FedeVerstraeten/actuador_electrodinamico/Anteproyecto/styles/cover.tex

%******************************************************
%* Santiago Roman (FIUBA #93947)
%******************************************************
% Estilo de la caratula
% -----------------------------------------------------

\thispagestyle{empty}
\newgeometry{twoside, left=2.5cm,top=1cm,right=2.5cm,bottom=1cm,bindingoffset=.5cm}
\begin{titlepage}

\begin{minipage}{0.48\textwidth} \begin{flushleft}
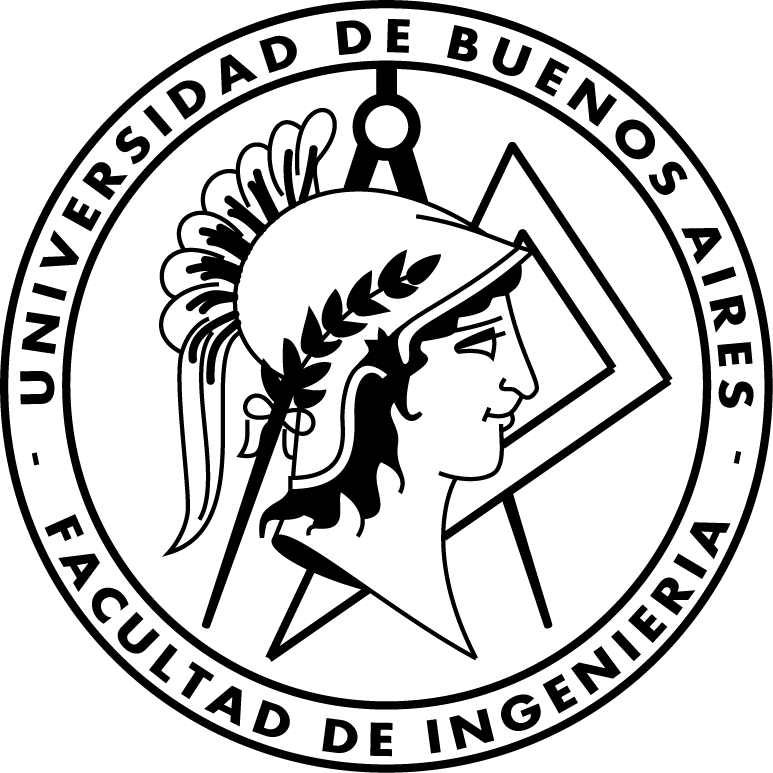
[picture p1: Anteproyecto/images/logo_fiuba.png]

\end{flushleft}\end{minipage}
\begin{minipage}{0.6\textwidth} \begin{flushright}
    \textsc{\Large \universidad}\\[0.5 cm]	% Nombre universidad
    \textsc{\Large \facultad}\\[2.0 cm]	% Facultad
\end{flushright}\end{minipage}

	\centering
%     \includegraphics[scale = 0.75]{images/logo_fiuba.png}\\[1.0 cm]	% Logo universidad
%     \textsc{\LARGE \universidad}\\[0.5 cm]	% Nombre universidad
%     \textsc{\Large \facultad}\\[2.0 cm]	% Facultad
%     \textsc{\Large \cuatrimestre}\\[2.0 cm]	% Cuatrimestre
% 	\textsc{\Large \codigoMateria}\\[0.5 cm] % Código materia
% 	\textsc{\large \nombreMateria}\\[0.5 cm] % Nombre materia
    \textsc{\large }\\[0.5 cm]
    \textsc{\large \nombreMateria  (\codigoMateria)}\\[0.5 cm] % Nombre materia
	\rule{\linewidth}{0.2 mm} \\[0.4 cm]
	{ \huge \tituloTP}\\[0.0cm]
	\rule{\linewidth}{0.2 mm} \\[1.5 cm]

\begin{table}[H]
\centering
\begin{tabular}{|l|l|l|}
\hline
Anteproyecto                  & \multicolumn{2}{l|}{Nombre del proyecto} \\ \hline
\multirow{3}{*}{Autores} &    Santiago Román       &     93947      \\ \cline{2-3} 
                  &     Santiago Román      &     93947      \\ \cline{2-3} 
                  &     Santiago Román      &     93947      \\ \hline
Turno de TP:                  & \multicolumn{2}{l|}{1 (Martes 19 a 22 hs)} \\ \hline
Docente Guía:                  &     \multicolumn{2}{l|}{Apellido, Nombre}                 \\ \hline
\end{tabular}
\end{table}

\begin{table}[H]
\centering
\begin{tabularx}{\textwidth}{|l|l|l|}
\hline
Anteproyecto                  & \multicolumn{2}{l|}{Nombre del proyecto} \\ \hline
\multirow{3}{*}{Autores} &    Santiago Román       &     93947      \\ \cline{2-3} 
                  &     Santiago Román      &     93947      \\ \cline{2-3} 
                  &     Santiago Román      &     93947      \\ \hline
Turno de TP:                  & \multicolumn{2}{l|}{1 (Martes 19 a 22 hs)} \\ \hline
Docente Guía:                  &     \multicolumn{2}{l|}{Apellido, Nombre}                 \\ \hline
\end{tabularx}
\end{table}

	\begin{minipage}{0.5\textwidth}
		\begin{flushleft} \large
			\emph{Integrante:}\\
		\end{flushleft}
	\end{minipage}~
	\begin{minipage}{0.4\textwidth}
		\begin{flushright} \large
			\emph{Padrón:} \\
		\end{flushright}
	\end{minipage}\\

    % Agregar aqui los integrantes del trabajo
    \teammember{Román, Santiago}{93947}{santiago\_roman@outlook.com}
    \teammember{Verstraeten, Federico}{XXXXX}{federico.verstraeten@gmail.com}
    \teammember{Zarza, Ezequiel Martín}{XXXXX}{ezequielm.zarza@gmail.com}

    \vfill
	
	{\large \today}\\[2 cm]
 
	\vfill

\end{titlepage}
\restoregeometry
