FedeVerstraeten/actuador_electrodinamico/Anteproyecto/0main.tex

\documentclass[a4paper]{styles/clase_fiuba}

\newcommand{\codigoMateria}{66.09 / 86.07}
\newcommand{\nombreMateria}{Laboratorio de Microprocesadores}

\newcommand{\descripcionTP}{Controlador de un actuador electrodinámico aplicado a interferometría dinámica}
\newcommand{\tituloTP}{Informe de Anteproyecto}

\newcommand{\facultad}{Facultad de Ingeniería}
\newcommand{\universidad}{Universidad de Buenos Aires}
\newcommand{\cuatrimestre}{1er Cuatrimestre de 2016}

\usepackage{styles/estilo_fiuba}

% ---------------------------------------------------------------
% Inicio documento
\begin{document}
\nocite{*}
% ---------------------------------------------------------------
% Caratula e índice
\includepdf[pages={1}]{caratula.pdf}
\clearpage

\pagenumbering{Roman}

\tableofcontents
\clearpage
% ---------------------------------------------------------------
% Cuerpo del informe.
\pagenumbering{arabic}
\pagestyle{fancy}

\input{1objet}

\input{2descrip}

\input{3especif}

\input{4perif}

\input{5diag_bloq}

\input{6diag_flujo}

\input{7plan_trabajo}

\input{8componentes}

\include{9fact_exito}

% --------------------------------------------------
% Bibliografías
%\bibliography{biblio}{}
%\bibliographystyle{plain}
%\clearpage
% --------------------------------------------------
% Fin del informee
\end{document}
