FedeVerstraeten/actuador_electrodinamico/Anteproyecto/5diag_bloq.tex

\section{Diagrama de bloques preliminar}
\label{sec:diag_bloq}
Quisque erat metus, cursus in pellentesque a, lobortis in diam. In hac habitasse platea dictumst. Nunc ac mauris ac felis luctus varius vel ac dui. Sed feugiat ullamcorper dolor, at aliquet ex ultricies id. Vivamus sed nulla sit amet magna consectetur elementum. Nulla sed lorem quis neque euismod feugiat et id leo. Aliquam placerat dapibus turpis. Cras sollicitudin vitae ante a feugiat. Fusce interdum quam a enim ultrices tristique. Vivamus sed volutpat turpis. Fusce feugiat velit id magna finibus convallis. Nulla malesuada leo id fermentum condimentum. Sed ultricies ornare metus varius varius.
