FedeVerstraeten/actuador_electrodinamico/Anteproyecto/9fact_exito.tex

\section{Factores críticos de éxito}
\label{sec:fact_exito}

Es importante analizar cuáles son los riesgos potenciales más importantes que podrían dificultar la realización del proyecto. Una vez identificados, conviene hacerles un seguimiento cercano para evitar contratiempos.

- Desarrollo de inferfaz entre
