FedeVerstraeten/actuador_electrodinamico/Informe/Caratula_Informe_Final.pdf

LABORATORIO DE MICROPROCESADORES (86.07) LABORATORIO DE MICROCOMPUTADORAS (66.09)

INFORME FINAL DE PROYECTO

Anteproyecto: | Controlador de un actuador electrodinámico aplicado a interferometría dinámica
Autores: | Roman, Santiago | 93947
| Verstraeten, Federico | 92892
| Zarza, Ezequiel M. | 93883
Turno de TP: | 1 (Martes 19 a 22hs)
Docente Guía: |

Observaciones generales

Aceptación del docente:

Fecha
