FedeVerstraeten/actuador_electrodinamico/ejemplos/lcd/conexiones vista lcd.gif

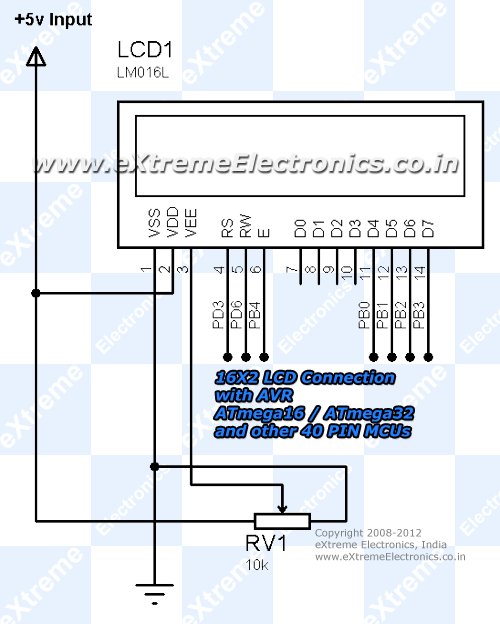
ejemplos/lcd/conexiones vista lcd.gif
