FedeVerstraeten/actuador_electrodinamico/ejemplos/poster/espectrofotocolrímetro.png

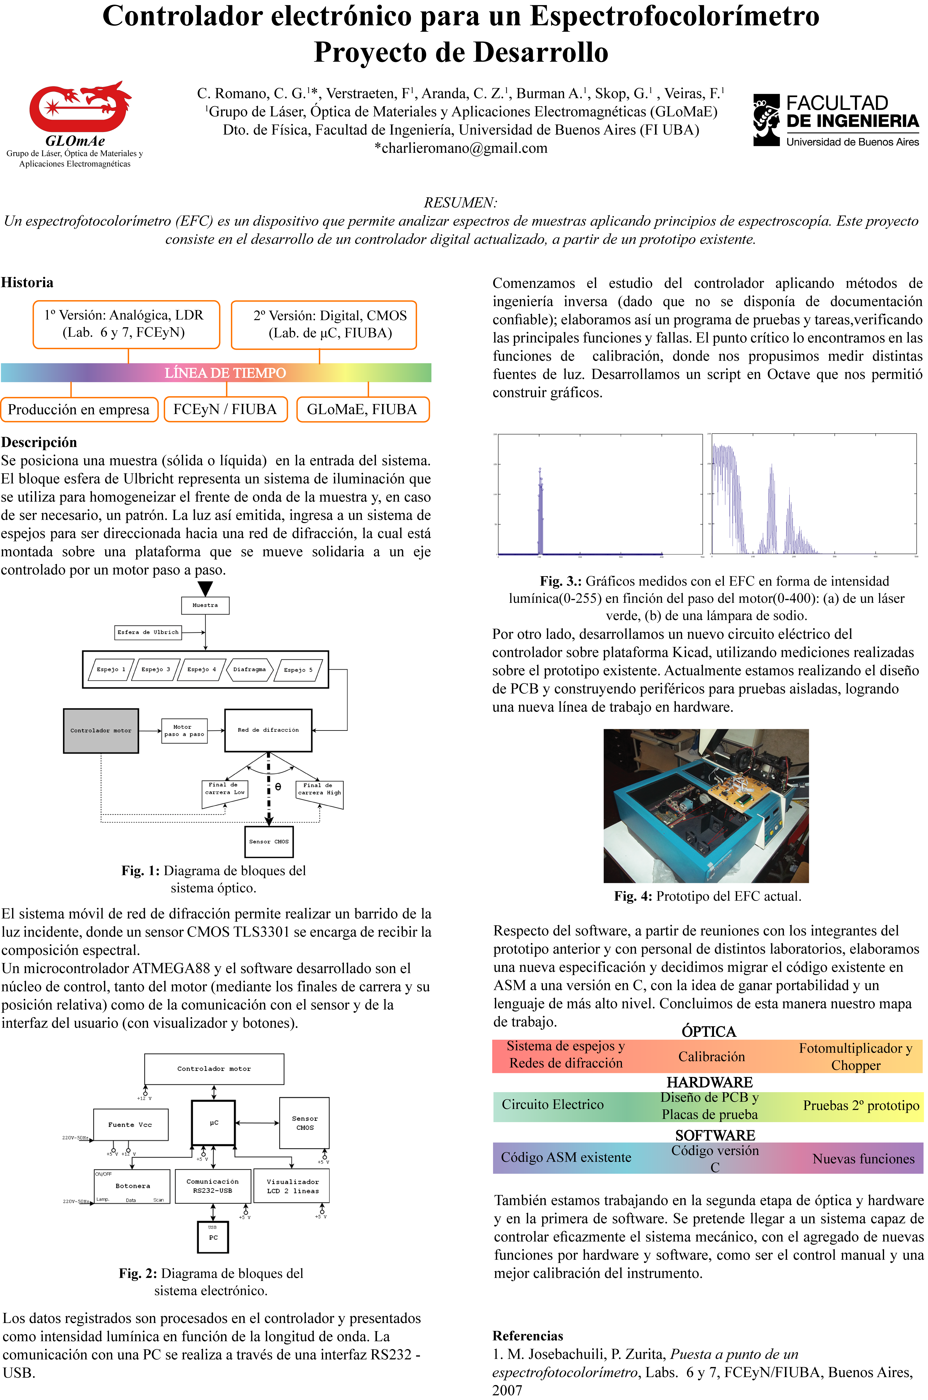
ejemplos/poster/espectrofotocolrímetro.png
