FedeVerstraeten/actuador_electrodinamico/Informe/images/atmega328p.jpg

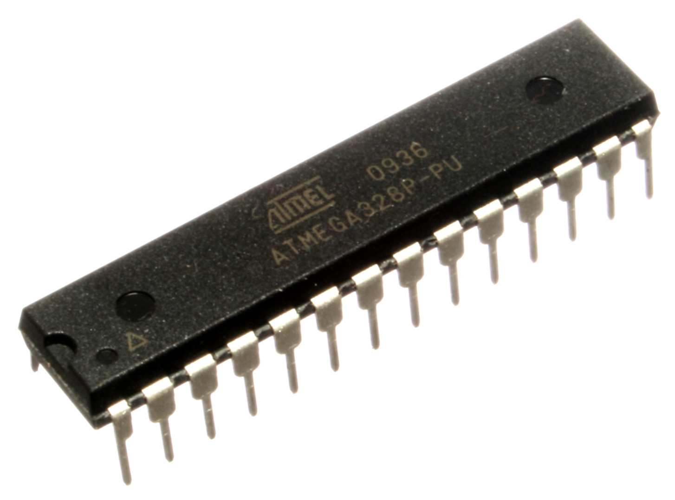
Informe/images/atmega328p.jpg
