FedeVerstraeten/actuador_electrodinamico/Informe/images/Diagrama_en_bloques.png

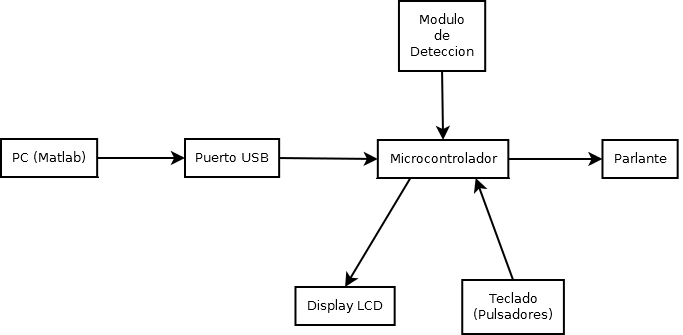
Informe/images/Diagrama_en_bloques.png
