FedeVerstraeten/actuador_electrodinamico/Informe/images/parlante_espejov2.png

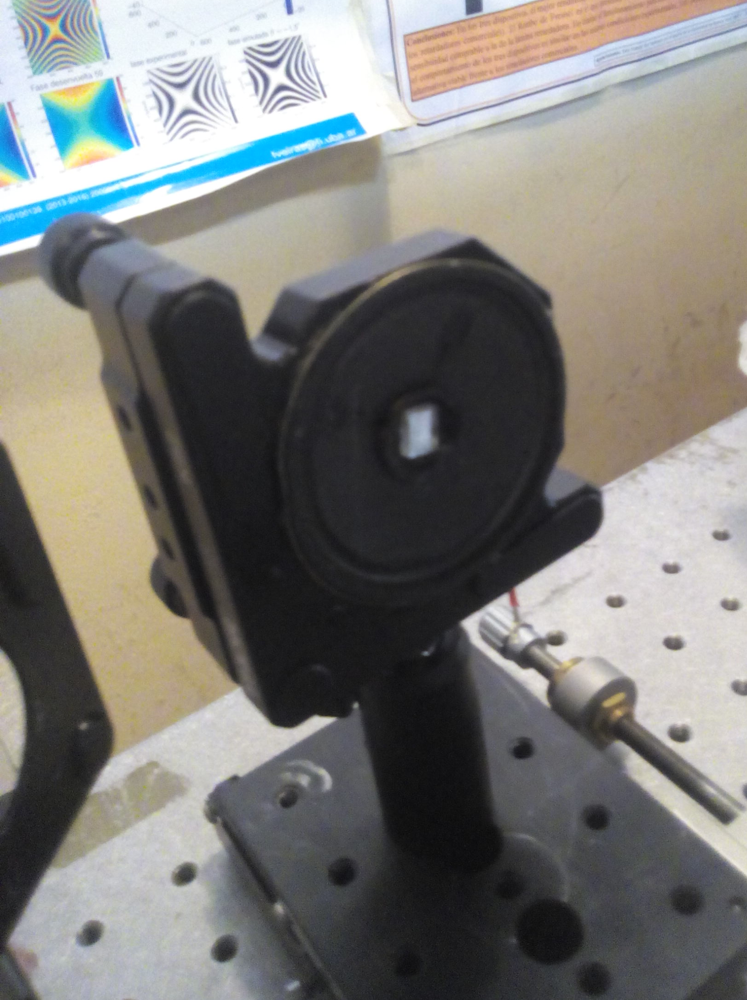
Informe/images/parlante_espejov2.png
