FedeVerstraeten/actuador_electrodinamico/Poster/img/interferometro1.jpg

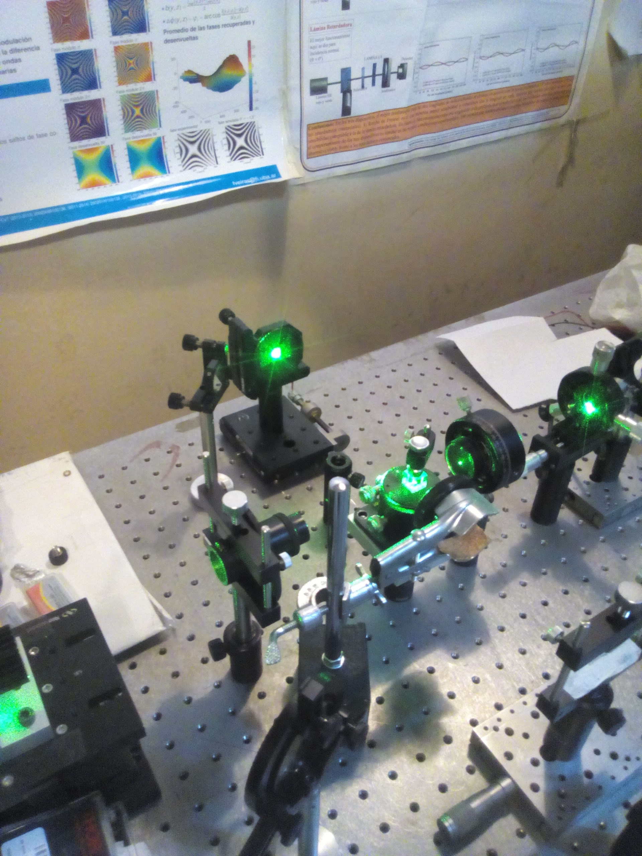
Poster/img/interferometro1.jpg
