FedeVerstraeten/actuador_electrodinamico/Poster/img/interferometro3.jpg

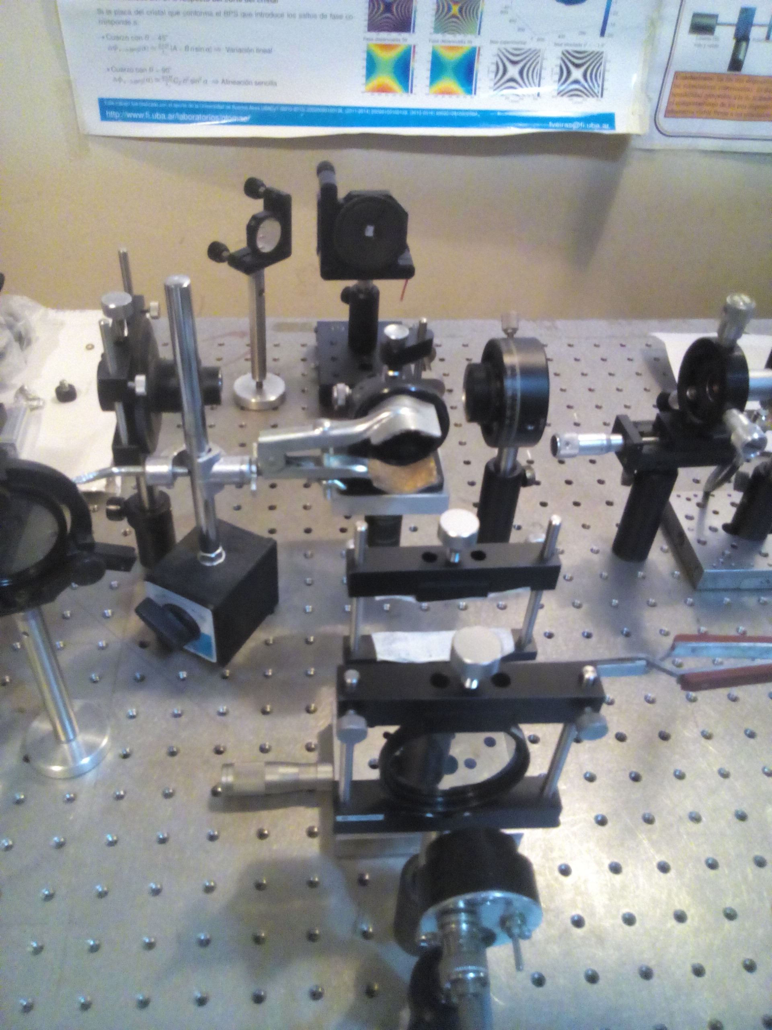
Poster/img/interferometro3.jpg
