FedeVerstraeten/actuador_electrodinamico/Poster/img/parlante_espejo.png

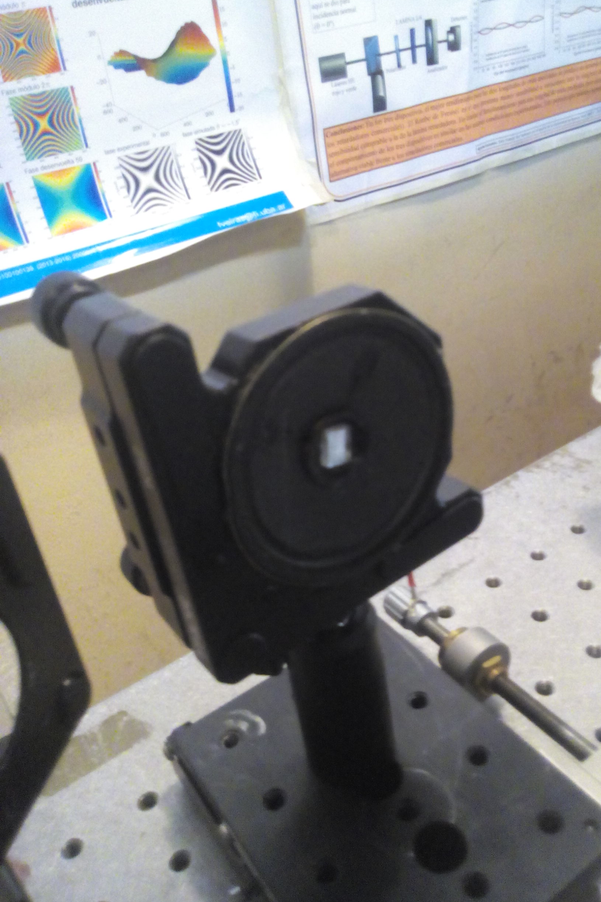
Poster/img/parlante_espejo.png
