FedeVerstraeten/actuador_electrodinamico/Informe/8componentes.tex

\section{Listado de componentes y costos estimados}
\label{sec:componentes}

\begin{table}[H]
  \centering
  \begin{tabular}{ll}
    \toprule
    Componente & Costo estimado \\
    \midrule
    Microcontrolador ATMega32 & \$ 225 \\
    Placa experimental & \$ 150 \\
    Soporte & \$ - \\
    Placa USB a Serie & \$ 120 \\
	Display LCD  & \$ 120 \\
	Parlante & \$ 50 \\
    4x Botones & \$ 20 \\
    Fotodiodo & \$ 5 \\
    16x Resistencias\footnote{Se incluyen a las resistencias ya que a pesar de ser un componente muy básico que en general no merece ser destacado en este caso estas resistencias conforman el conversor digital-analógico que se utilizó.} & \$ 10\\
    Cristal $\SI{16}{\mega \hertz}$ & \$ 6 \\
    \midrule
    Total & $\approx$ \$ 706 \\
    \bottomrule
  \end{tabular}
  \caption{Costos estimados para la realización del proyecto.}
  \label{table:costos}
\end{table}
