FedeVerstraeten/actuador_electrodinamico/Anteproyecto/8componentes.tex

\section{Listado de componentes y costos estimados}
\label{sec:componentes}

\begin{table}[H]
  \centering
  \begin{tabular}{ll}
    \toprule
    Componente & Costo estimado \\
    \midrule
    Microprocesador ATMega328p & \$ 110 \\
    Placa experimental & \$ ?? \\
    Soporte & \$ ?? \\
    Placa USB a Serie & $\approx$ \$ 120 \\
	Parlante & \$ ?? \\
    \midrule
    Total & \$ ?? \\
    \bottomrule
  \end{tabular}
  \caption{Costos estimados para la realización del proyecto.}
  \label{table:costos}
\end{table}
