FedeVerstraeten/actuador_electrodinamico/Informe/images/resultados_rampa_precargada.jpg

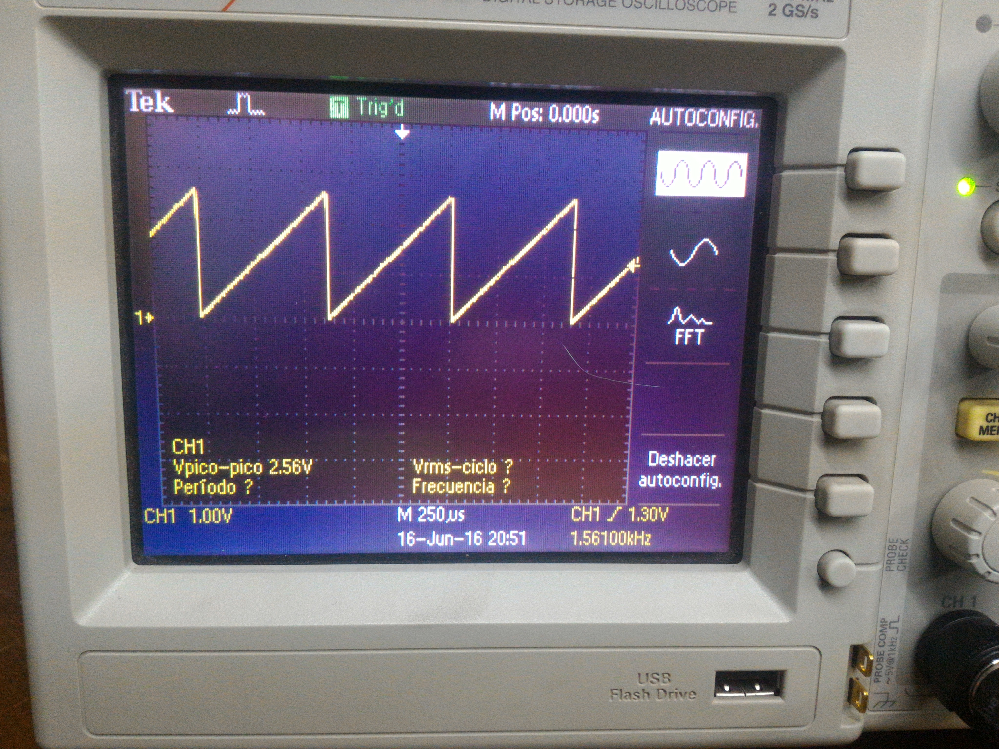
Informe/images/resultados_rampa_precargada.jpg
