FedeVerstraeten/actuador_electrodinamico/Informe/images/resultados_seno_precargada.jpg

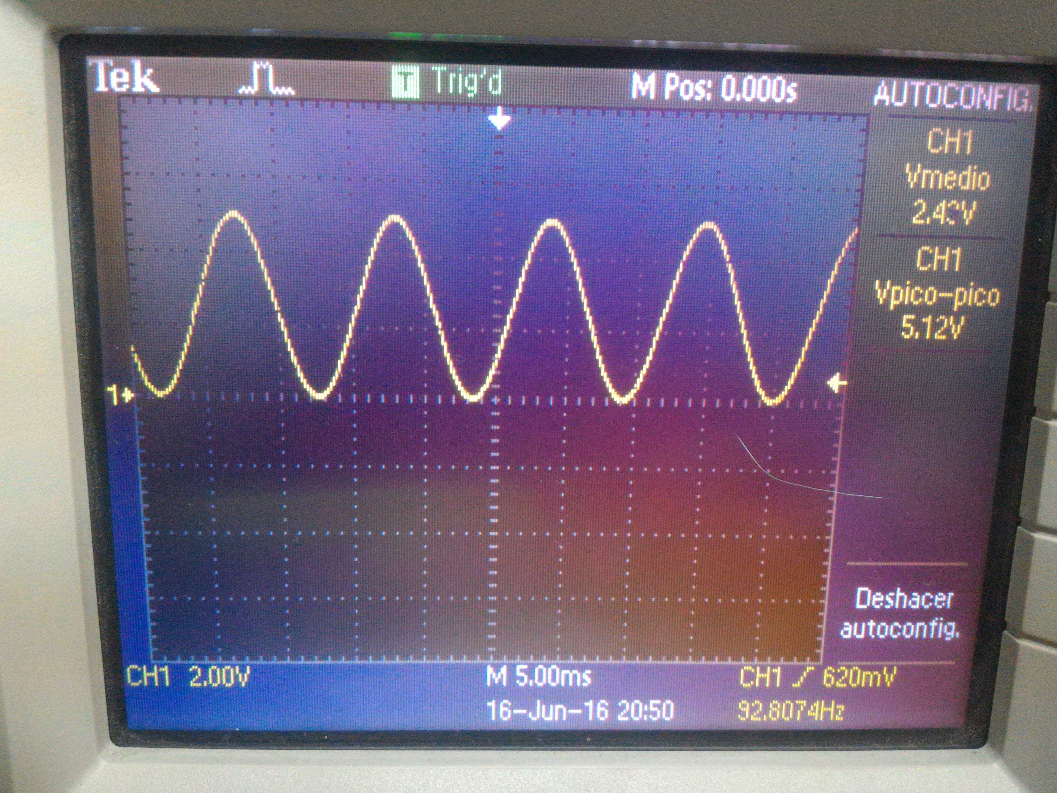
Informe/images/resultados_seno_precargada.jpg
