FedeVerstraeten/actuador_electrodinamico/Informe/images/ProyectoLaboratorioMicroprocesadores.PDF

J1

X1

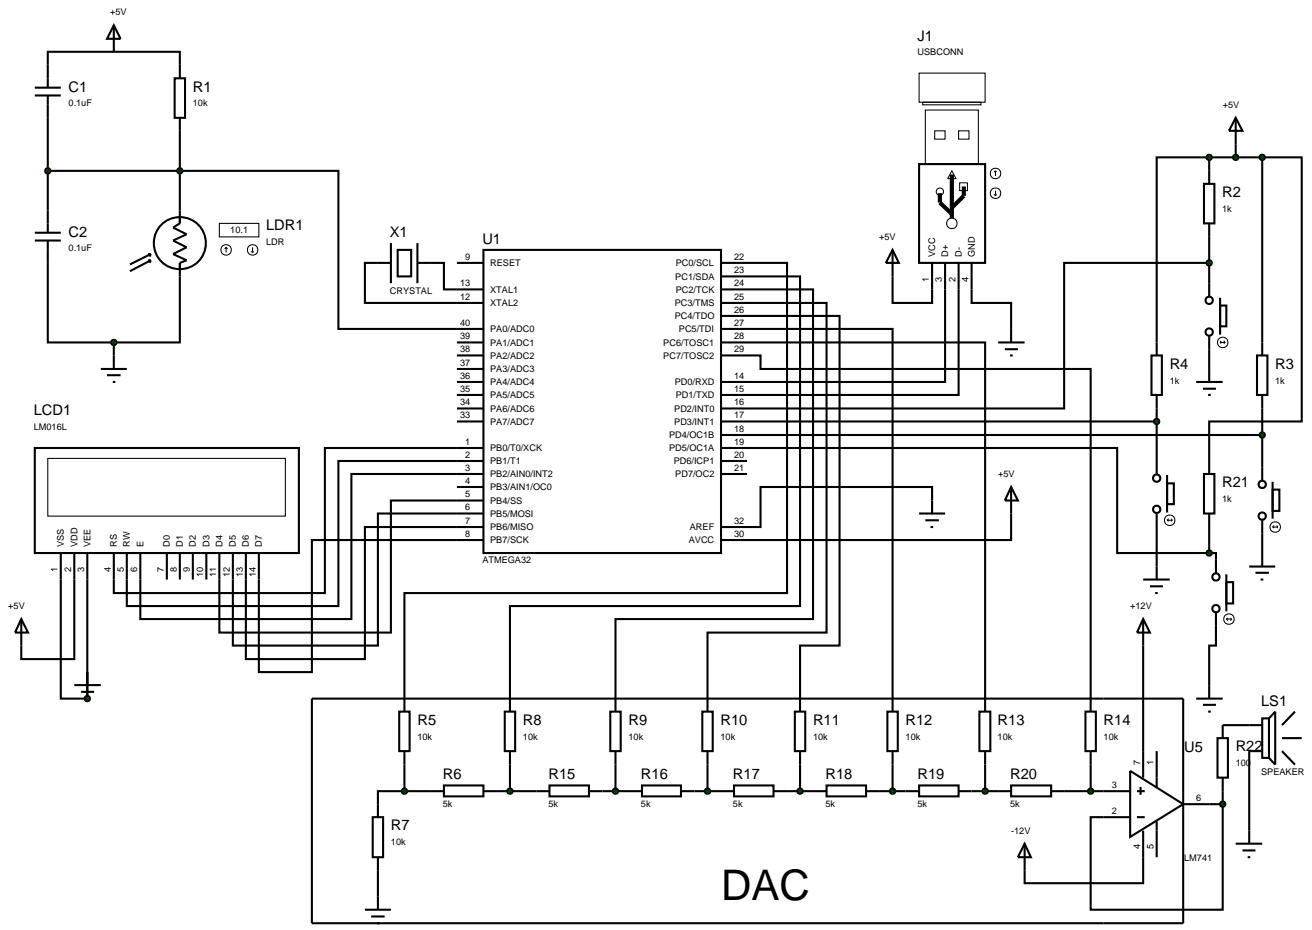
[picture p25: page 1]
