FedeVerstraeten/actuador_electrodinamico/Poster/img/Demodulacion.pdf

# Desfasaje Continuo:

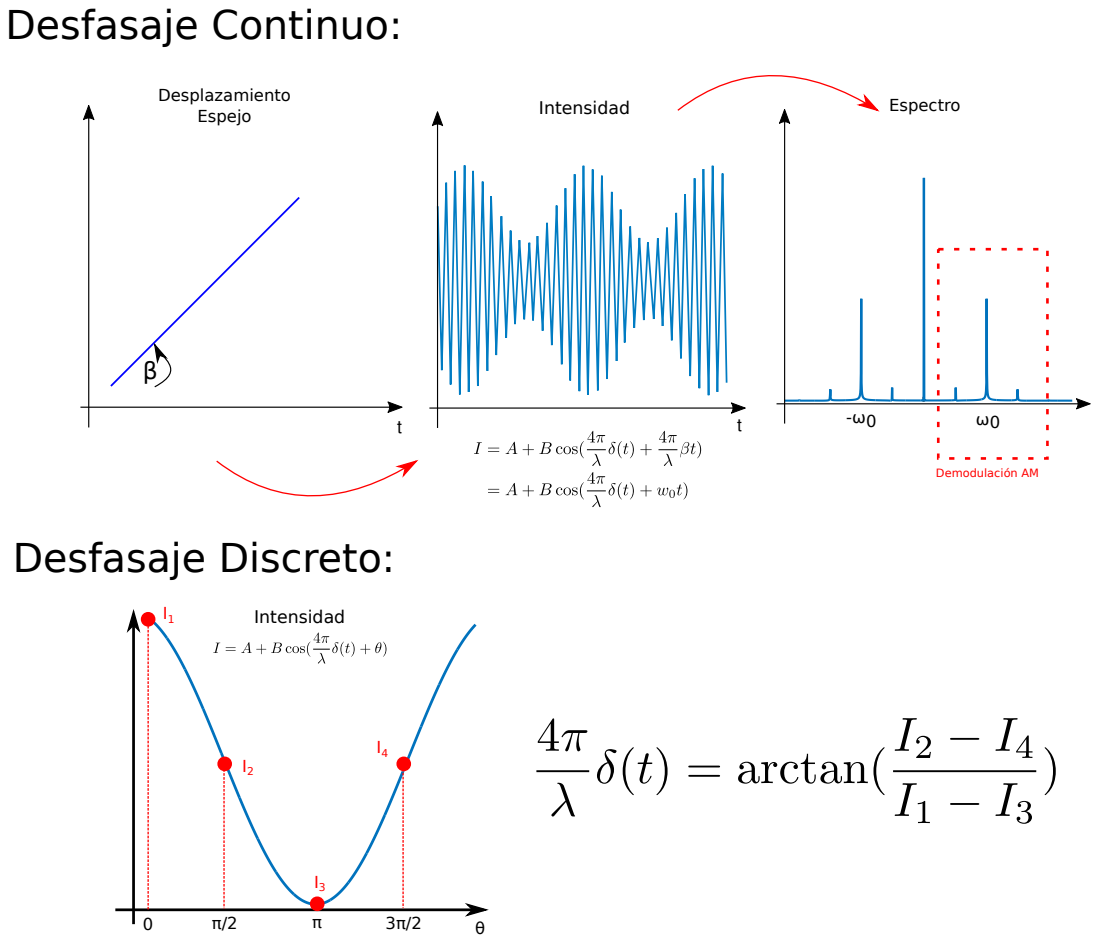
[picture p26: page 1]
Desfasaje Discreto:; Intensidad; Desplazamiento; Espejo; Espectro; Demodulación AM
