FedeVerstraeten/actuador_electrodinamico/Poster/img/desfasaje_continuo.pdf

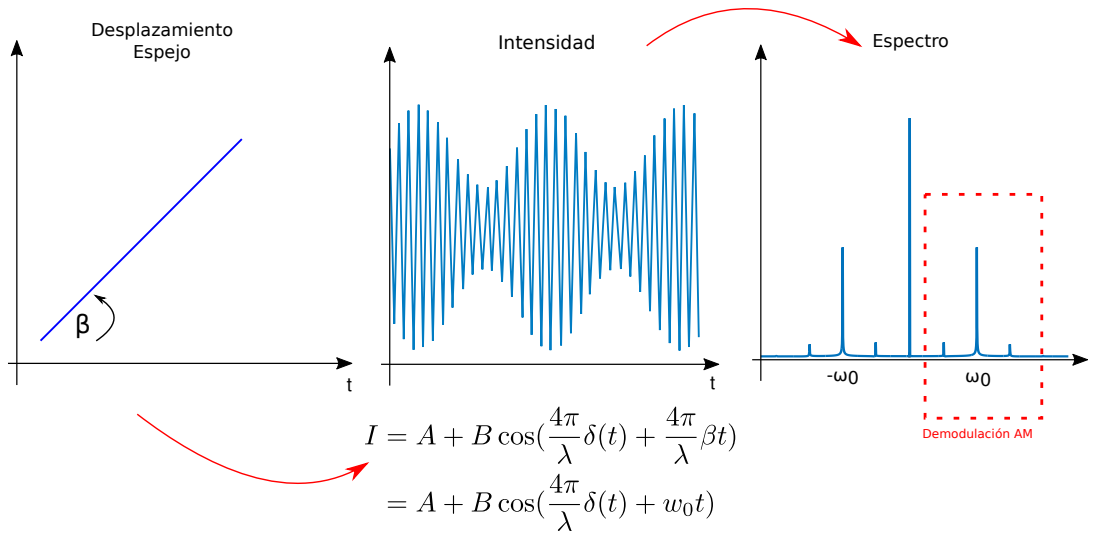
[picture p27: page 1]
Intensidad; Espectro; Demodulación AM; Desplazamiento Espejo
