FedeVerstraeten/actuador_electrodinamico/Poster/img/desfasaje_discreto.pdf

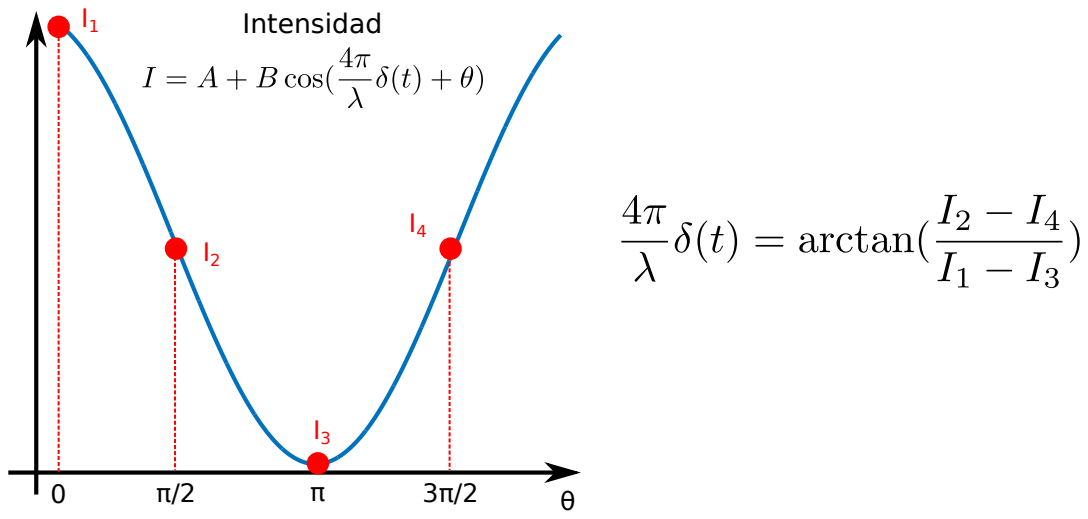
[picture p28: page 1]
Intensidad
