FedeVerstraeten/actuador_electrodinamico/Poster/img/diagrama_de_bloques.pdf

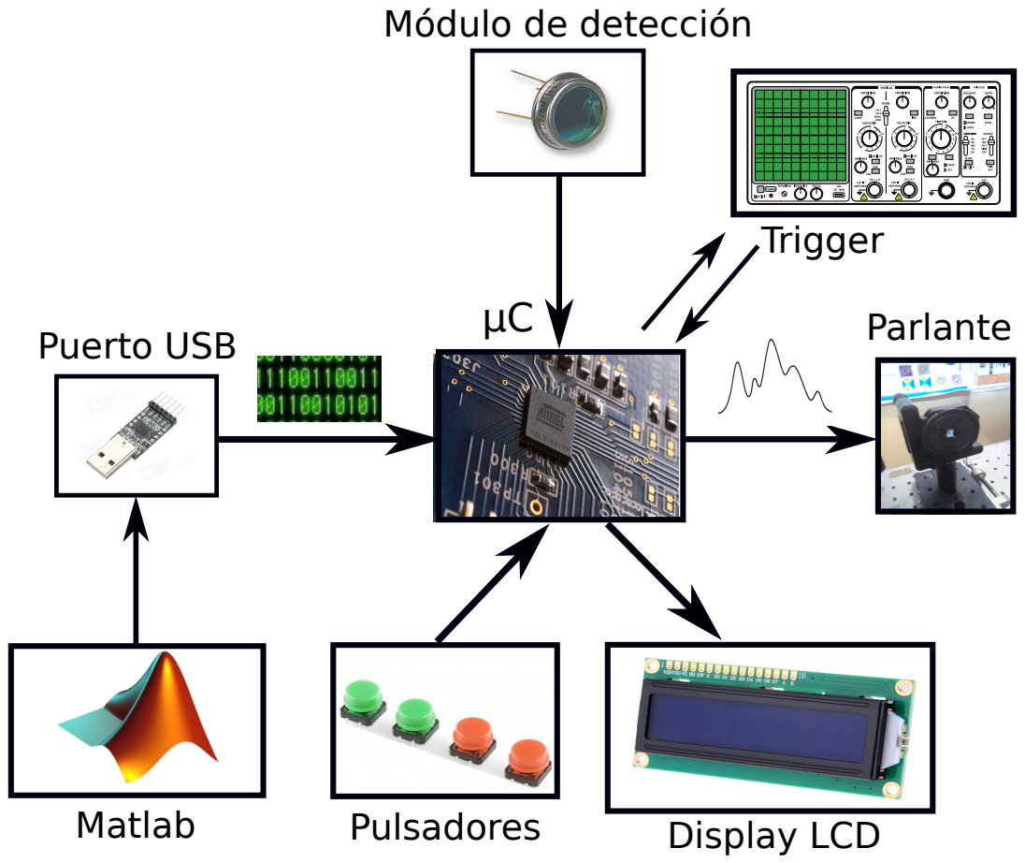
[picture p29: page 1]
Matlab; Pulsadores; Display LCD; Parlante Puerto USB; Trigger

Módulo de detección
