FedeVerstraeten/actuador_electrodinamico/Poster/img/logo_fiuba.pdf

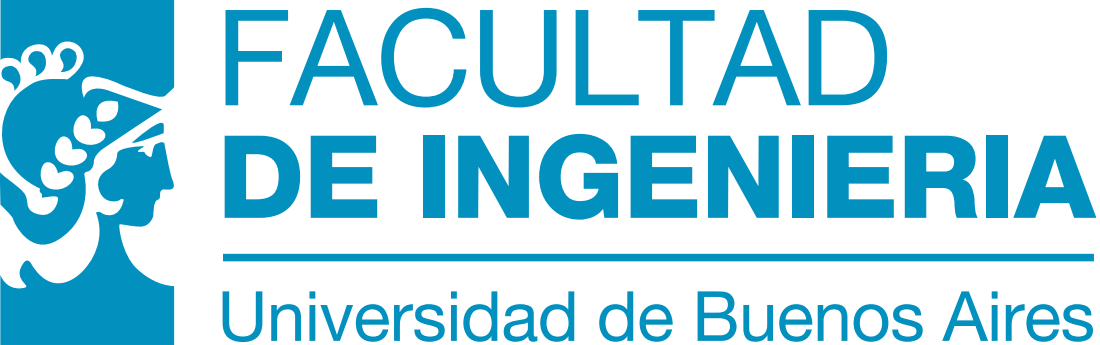
[picture p30: page 1]
