FedeVerstraeten/actuador_electrodinamico/Poster/img/logo_topfot.pdf

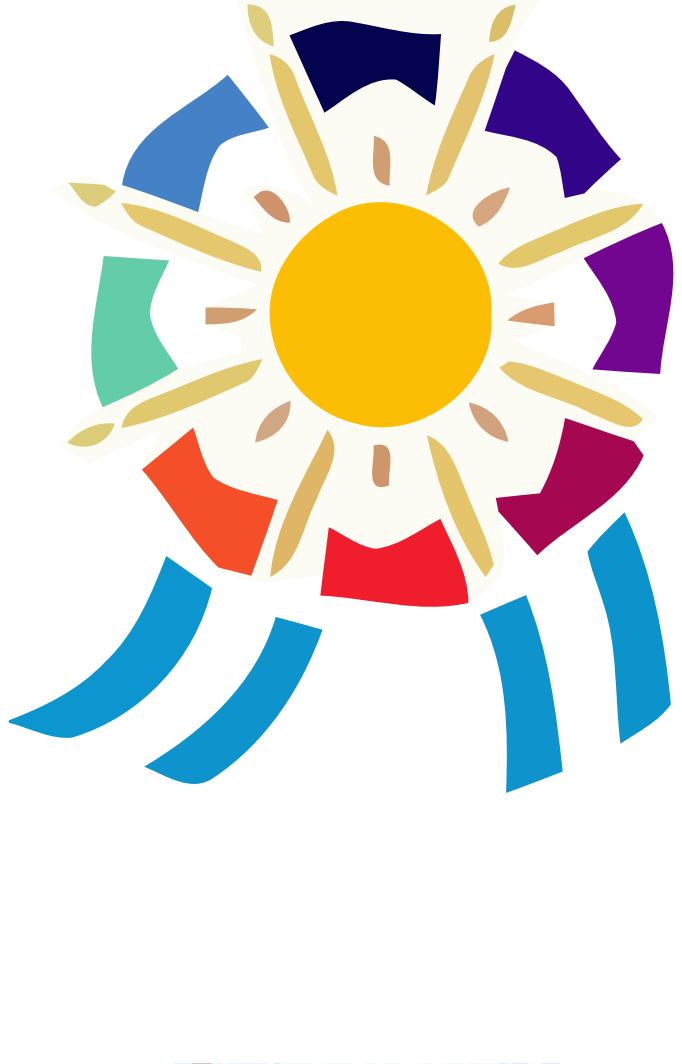
[picture p31: page 1]
