FedeVerstraeten/actuador_electrodinamico/Poster/img/logo_UBA_cian.pdf

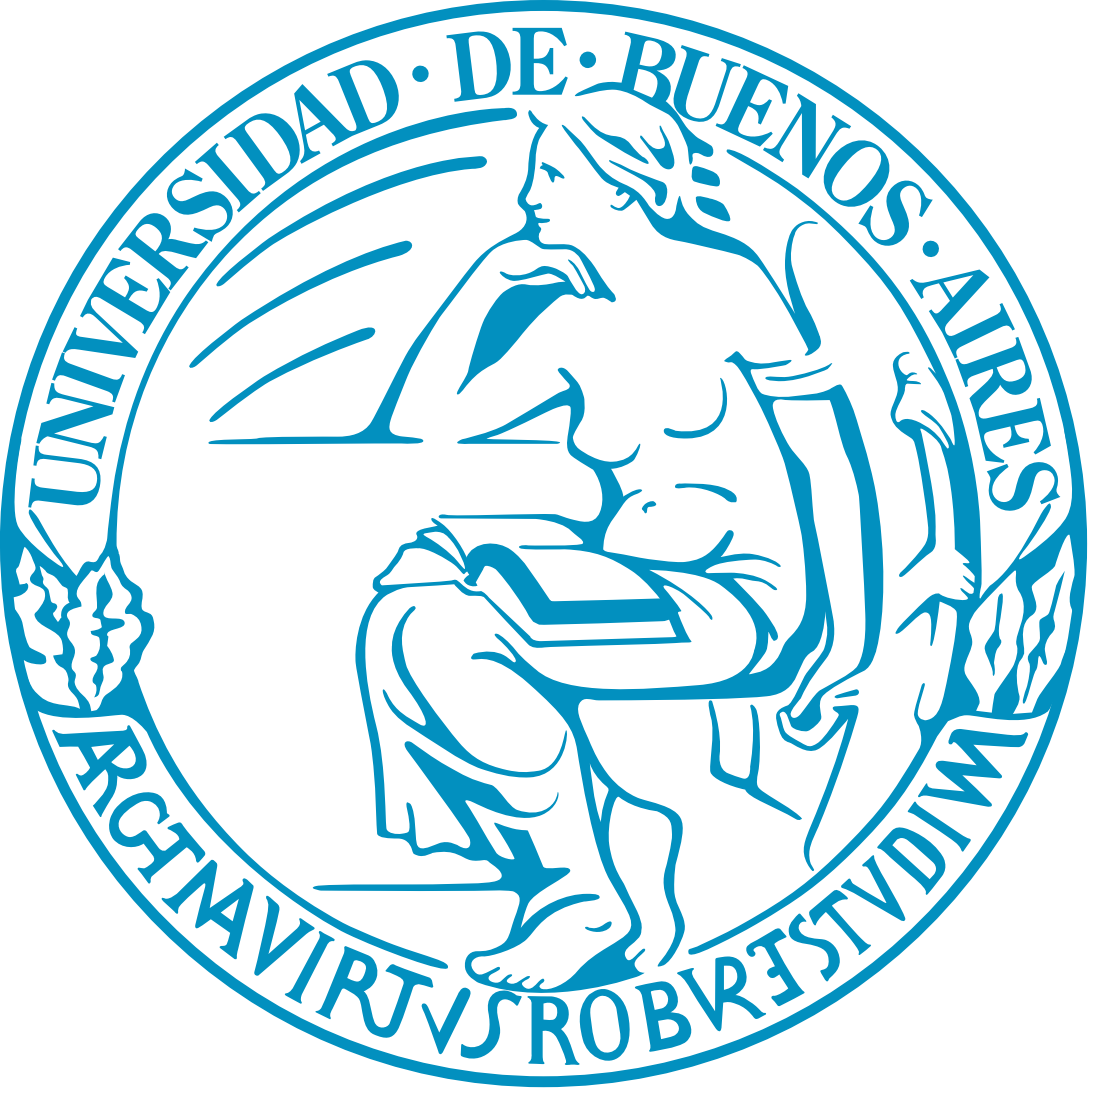
[picture p32: page 1]
