FedeVerstraeten/actuador_electrodinamico/Poster/img/mediciones.pdf

1.52

2.53

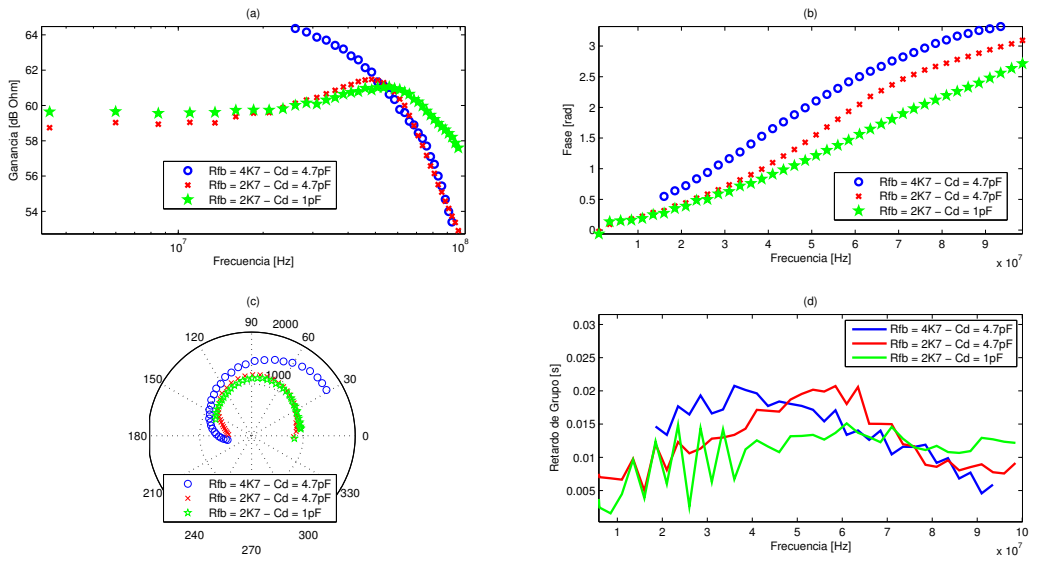
[picture p33: page 1]
Frecuencia [Hz]; Rfb = 4K7 − Cd = 4.7pF Rfb = 2K7 − Cd = 4.7pF Rfb = 2K7 − Cd = 1pF; Fase [rad]

Ganancia [dB Ohm]

Retardo de Grupo [s]
