FedeVerstraeten/actuador_electrodinamico/Poster/img/michelson.pdf

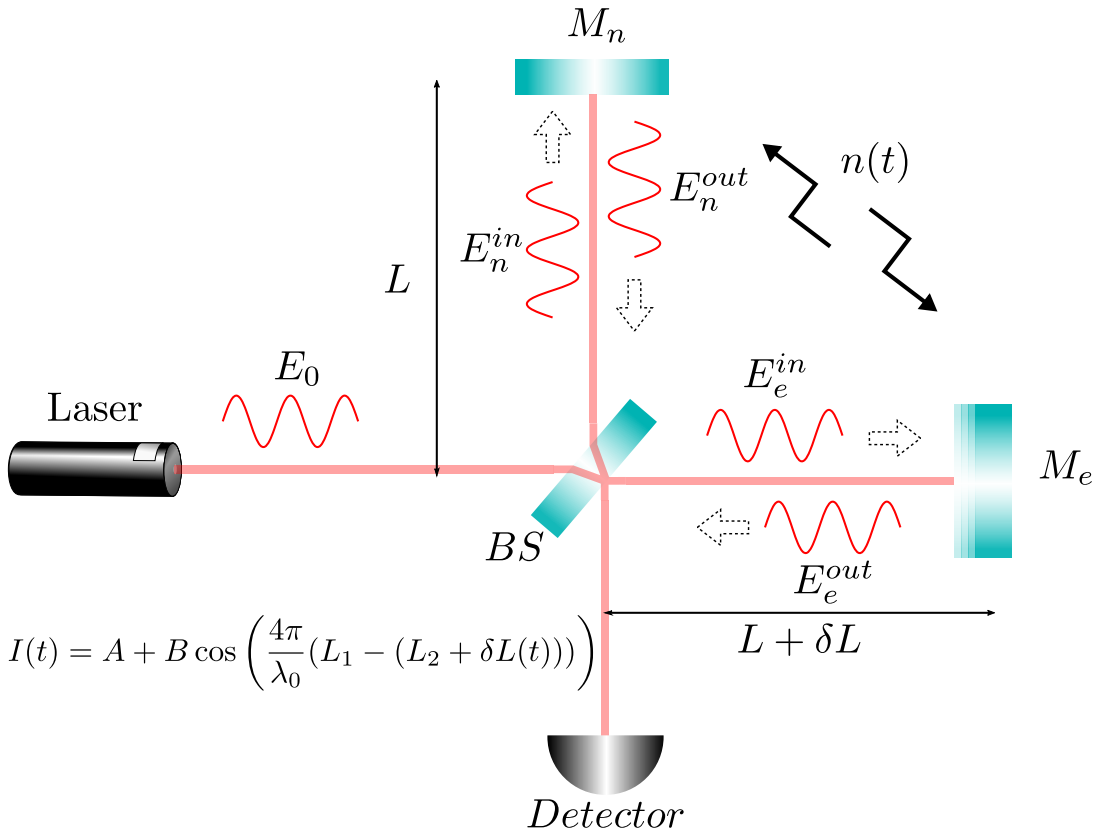
[picture p34: page 1]
