FedeVerstraeten/actuador_electrodinamico/(list of files, drawings)

Other design files:
test/simulacionRampaProteus/signaRampaAnteproyecto.pdsprj
test/simulacionSenoProteus/pruebaSenoProteus.pdsprj
