FedeVerstraeten/actuador_electrodinamico/(commit log)

2016-04-05 Agrego el informe como esta hasta ahora en overleaf!
2016-04-29 Agrego ejemplos de lcd y poster
2016-04-29 Agregado de carpeta, readme e inicializacion de c?digos src
2016-04-30 Agregado de archivos includes para dar una primer estructura. Continuar modificaciones
2016-05-04 Subida de archivos con definiciones en /asminc
2016-05-08 Diagrama de flujo men? primer versi?n. Utilizando programa Dia.
2016-05-31 Subida c?digos de prueba LCD, de Ezequiel
2016-06-03 Breve limpieza de codigo mientras entiendo como funcionan las cosas.
2016-06-03 M?s limpieza, nada importante que ver aqui...
2016-06-04 Agrego ejemplo *bien basico* de comunicacion serie.
2016-06-04 Agrego el poster al repo.
2016-06-09 Agrego rutinas simples de USART
2016-06-09 Peque?o fix para USART
2016-06-09 Agrego rutinas comunes de delay y algo de limpieza
2016-06-09 Actualizo alias de registros
2016-06-10 Implemento lcd_putstring y hago algunos cambios en los nombres de algunas rutinas
2016-06-10 Agrego rutinas base de matlab y DAC (*incompletas*)
2016-06-10 Termino rutinas de matlab, falta la parte comun de enviar datos al DAC
2016-06-11 Codigo para mostrar funciones precargadas
2016-06-11 Creo que esta terminado todo lo relacionado a recibir muestras y mostrarlas por el DAC
2016-06-11 Agrego algunos comentarios al codigo para que se entienda mejor
2016-06-11 Mejoras al Makefile. Genero carpeta build donde se encuentran los archivos post-ensamblado. Cambio nombre de common.inc a delay.inc
2016-06-11 Codigo para boton de interrupcion
2016-06-11 Arreglo compilacion. Parece que hay un registro para interrupciones que aparece en el libro que no es necesario para este micro. Faltaria hacer pruebas
2016-06-11 Elimino archivos que no se usan.
2016-06-11 adjunto se?ales rampa y seno + sus simulaciones
    [pruebaSenoProteus.pdsprj, signaRampaAnteproyecto.pdsprj]
2016-06-11 Unifico la nomenclatura
2016-06-11 Mejor nomenclatura para funciones
2016-06-12 Agrego implementacion en C de la funcion seno
2016-06-12 Integro el codigo para armar la funcion diente de sierra
2016-06-13 Agrego link al datasheet completo del 324P en el README
2016-06-13 Correcci?n de identaci?n (tabulaci?n/sangrado) de c?digo
2016-06-14 Subida primera versi?n diagrama de flujo
2016-06-14 Elimino archivo de definiciones del 328 que no usamos (el 328P si lo dejo)
2016-06-15 subo la parte de medicion de intensidad, en C y Assembler
    [displayParaMedidor.txt]
2016-06-18 Subo seno prearmado en assembler listo para agregar al tp
2016-06-18 Rearmado completo del codigo del display. Ahora si que funciona! Tambien algunos cambios para el atmega32
2016-06-18 Elimino archivos que ya no usamos
2016-06-18 Agrego funcionalidad de display para rutinas de matlab
2016-06-18 Rutinas relacionadas con la medicion de intensidad
2016-06-18 Cambios para mostrar intensidad por display
2016-06-19 Limpieza general del codigo de intensidad y de signal
2016-06-19 Agrego el hex nuevo
2016-06-19 Limpieza de las rutinas de conversion binario a ascii
2016-06-19 Mejoras en la lectura de intensidad
2016-06-20 Corregi el codigo para que no salgan mas warnings con avra
2016-06-20 Cambie un poco el intensity
2016-06-20 Agrego ENDSIG en la lookup table del seno, si no estuviera esto el programa no sabe cuando terminan las muestras y hay que empezar de nuevo desde el principio
2016-06-21 Breve fix a la funcion de lectura por matlab, ahora deberia funcionar todo.
2016-06-21 Agrego el informe final
2016-06-21 Agregado a menu_def.inc funci?n triangulo y mensaje de bienvenida en menu.inc
2016-06-21 Limpio los registros tmp al hacer la interrupcion
